LegendLuhar/flight-controller/README.md

# Flight Controller PCB

Custom STM32G474-based flight controller PCB and firmware project focused on embedded systems, hardware design, and real-time firmware development.
