LegendLuhar/flight-controller/flight-controller.kicad_pcb

## KiCad design flight-controller.kicad_pcb (2026-10-30)

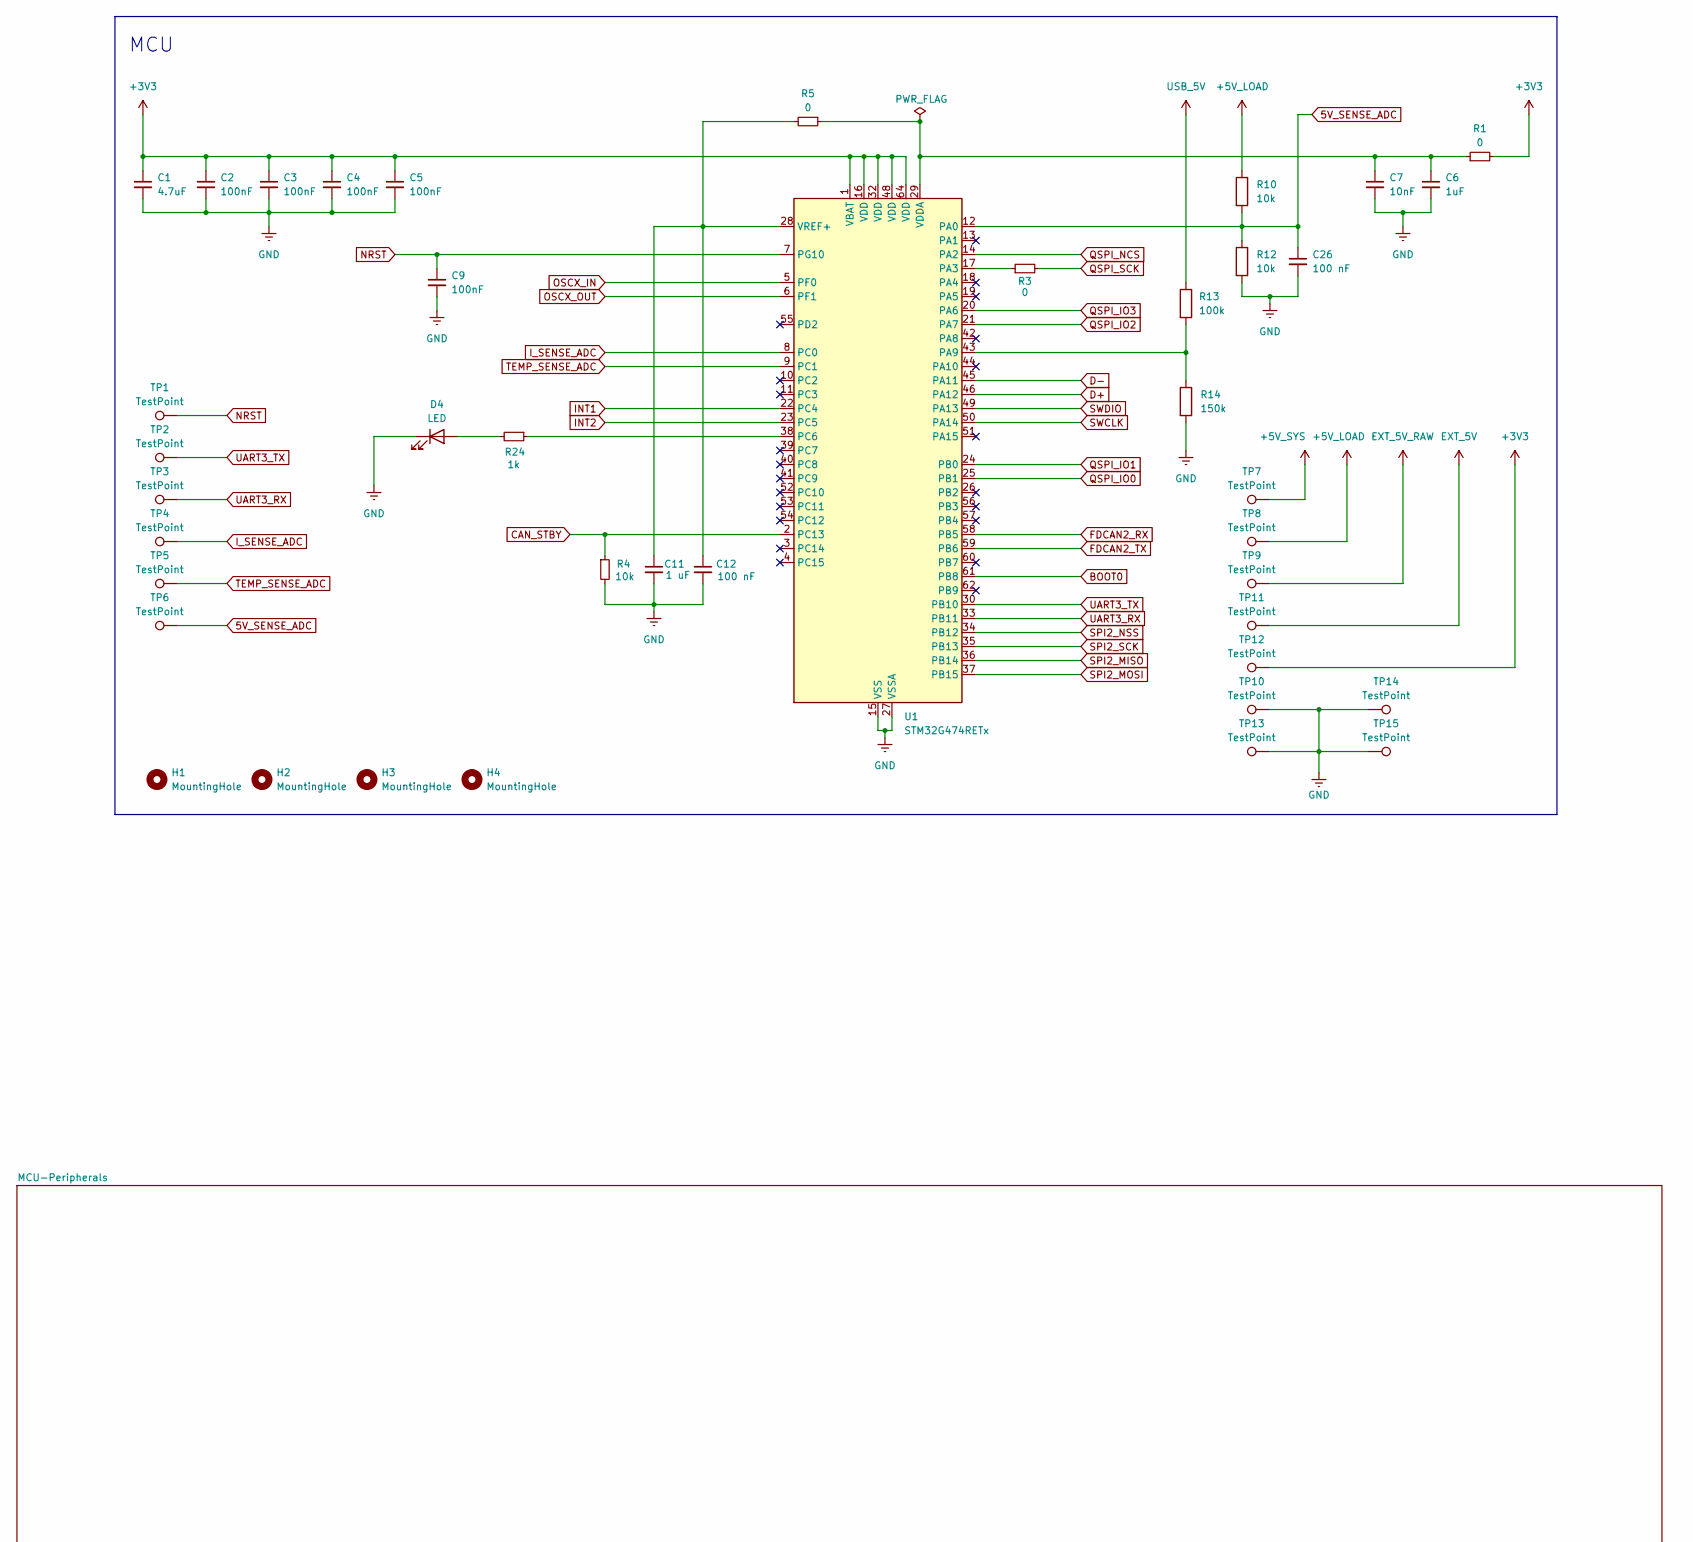
[picture p1: schematic flight-controller.kicad_sch, part in row 1, column 1]

Parts:
C1: 4.7uF; C_0805_2012Metric
C2, C3, C4, C5, C9: 100nF; C_0603_1608Metric
C6: 1uF; C_0603_1608Metric
C7: 10nF; C_0603_1608Metric
C11: 1 uF; C_0603_1608Metric
C12, C26: 100 nF; C_0603_1608Metric
D4: LED; LED_0603_1608Metric
H1, H2, H3, H4: MountingHole; MountingHole_3.2mm_M3_Pad_Via
R1, R3, R5: 0; R_0603_1608Metric
R4, R10, R12: 10k; R_0603_1608Metric
R13: 100k; R_0603_1608Metric
R14: 150k; R_0603_1608Metric
R24: 1k; R_0603_1608Metric
TP1, TP2, TP3, TP4, TP5, TP6, TP7, TP8, TP9, TP10, TP11, TP12, TP13, TP14, TP15: TestPoint; TestPoint_Pad_D1.0mm
U1: STM32G474RETx; LQFP-64_10x10mm_P0.5mm

Connections:
5V_SENSE_ADC: C26.1, R10.2, R12.1, TP6.1 (1_1), U1.12 (PA0)
+3V3: C1.1, C2.1, C3.1, C4.1, C5.1, R1.2, TP12.1 (1_1), U1.1 (VBAT), U1.16 (VDD), U1.32 (VDD), U1.48 (VDD), U1.64 (VDD); also elsewhere on the board
+5V_LOAD: R10.1, TP8.1 (1_1); also elsewhere on the board
+5V_SYS: TP7.1 (1_1); also elsewhere on the board
BOOT0: U1.61 (PB8); also elsewhere on the board
CAN_STBY: R4.1, U1.2 (PC13); also elsewhere on the board
D+: U1.46 (PA12); also elsewhere on the board
D-: U1.45 (PA11); also elsewhere on the board
EXT_5V: TP11.1 (1_1); also elsewhere on the board
EXT_5V_RAW: TP9.1 (1_1); also elsewhere on the board
FDCAN2_RX: U1.58 (PB5); also elsewhere on the board
FDCAN2_TX: U1.59 (PB6); also elsewhere on the board
GND: C1.2, C2.2, C3.2, C4.2, C5.2, C6.2, C7.2, C9.2, C11.2, C12.2, C26.2, D4.1 (K), R4.2, R12.2, R14.2, TP10.1 (1_1), TP13.1 (1_1), TP14.1 (1_1), TP15.1 (1_1), U1.15 (VSS), U1.27 (VSSA), U1.31 (VSS), U1.47 (VSS), U1.63 (VSS); also elsewhere on the board
INT1: U1.22 (PC4); also elsewhere on the board
INT2: U1.23 (PC5); also elsewhere on the board
I_SENSE_ADC: TP4.1 (1_1), U1.8 (PC0); also elsewhere on the board
NRST: C9.1, TP1.1 (1_1), U1.7 (PG10); also elsewhere on the board
unnamed: D4.2 (A), R24.2
unnamed: R3.1, U1.17 (PA3)
unnamed: R13.2, R14.1, U1.43 (PA9)
unnamed: R24.1, U1.38 (PC6)
unnamed: C6.1, C7.1, R1.1, R5.1, U1.29 (VDDA)
unnamed: C11.1, C12.1, R5.2, U1.28 (VREF+)
OSCX_IN: U1.5 (PF0); also elsewhere on the board
OSCX_OUT: U1.6 (PF1); also elsewhere on the board
QSPI_IO0: U1.25 (PB1); also elsewhere on the board
QSPI_IO1: U1.24 (PB0); also elsewhere on the board
QSPI_IO2: U1.21 (PA7); also elsewhere on the board
QSPI_IO3: U1.20 (PA6); also elsewhere on the board
QSPI_NCS: U1.14 (PA2); also elsewhere on the board
QSPI_SCK: R3.2; also elsewhere on the board
SPI2_MISO: U1.36 (PB14); also elsewhere on the board
SPI2_MOSI: U1.37 (PB15); also elsewhere on the board
SPI2_NSS: U1.34 (PB12); also elsewhere on the board
SPI2_SCK: U1.35 (PB13); also elsewhere on the board
SWCLK: U1.50 (PA14); also elsewhere on the board
SWDIO: U1.49 (PA13); also elsewhere on the board
TEMP_SENSE_ADC: TP5.1 (1_1), U1.9 (PC1); also elsewhere on the board
UART3_RX: TP3.1 (1_1), U1.33 (PB11); also elsewhere on the board
UART3_TX: TP2.1 (1_1), U1.30 (PB10); also elsewhere on the board
USB_5V: R13.1; also elsewhere on the board

Notes on the sheet:
MCU

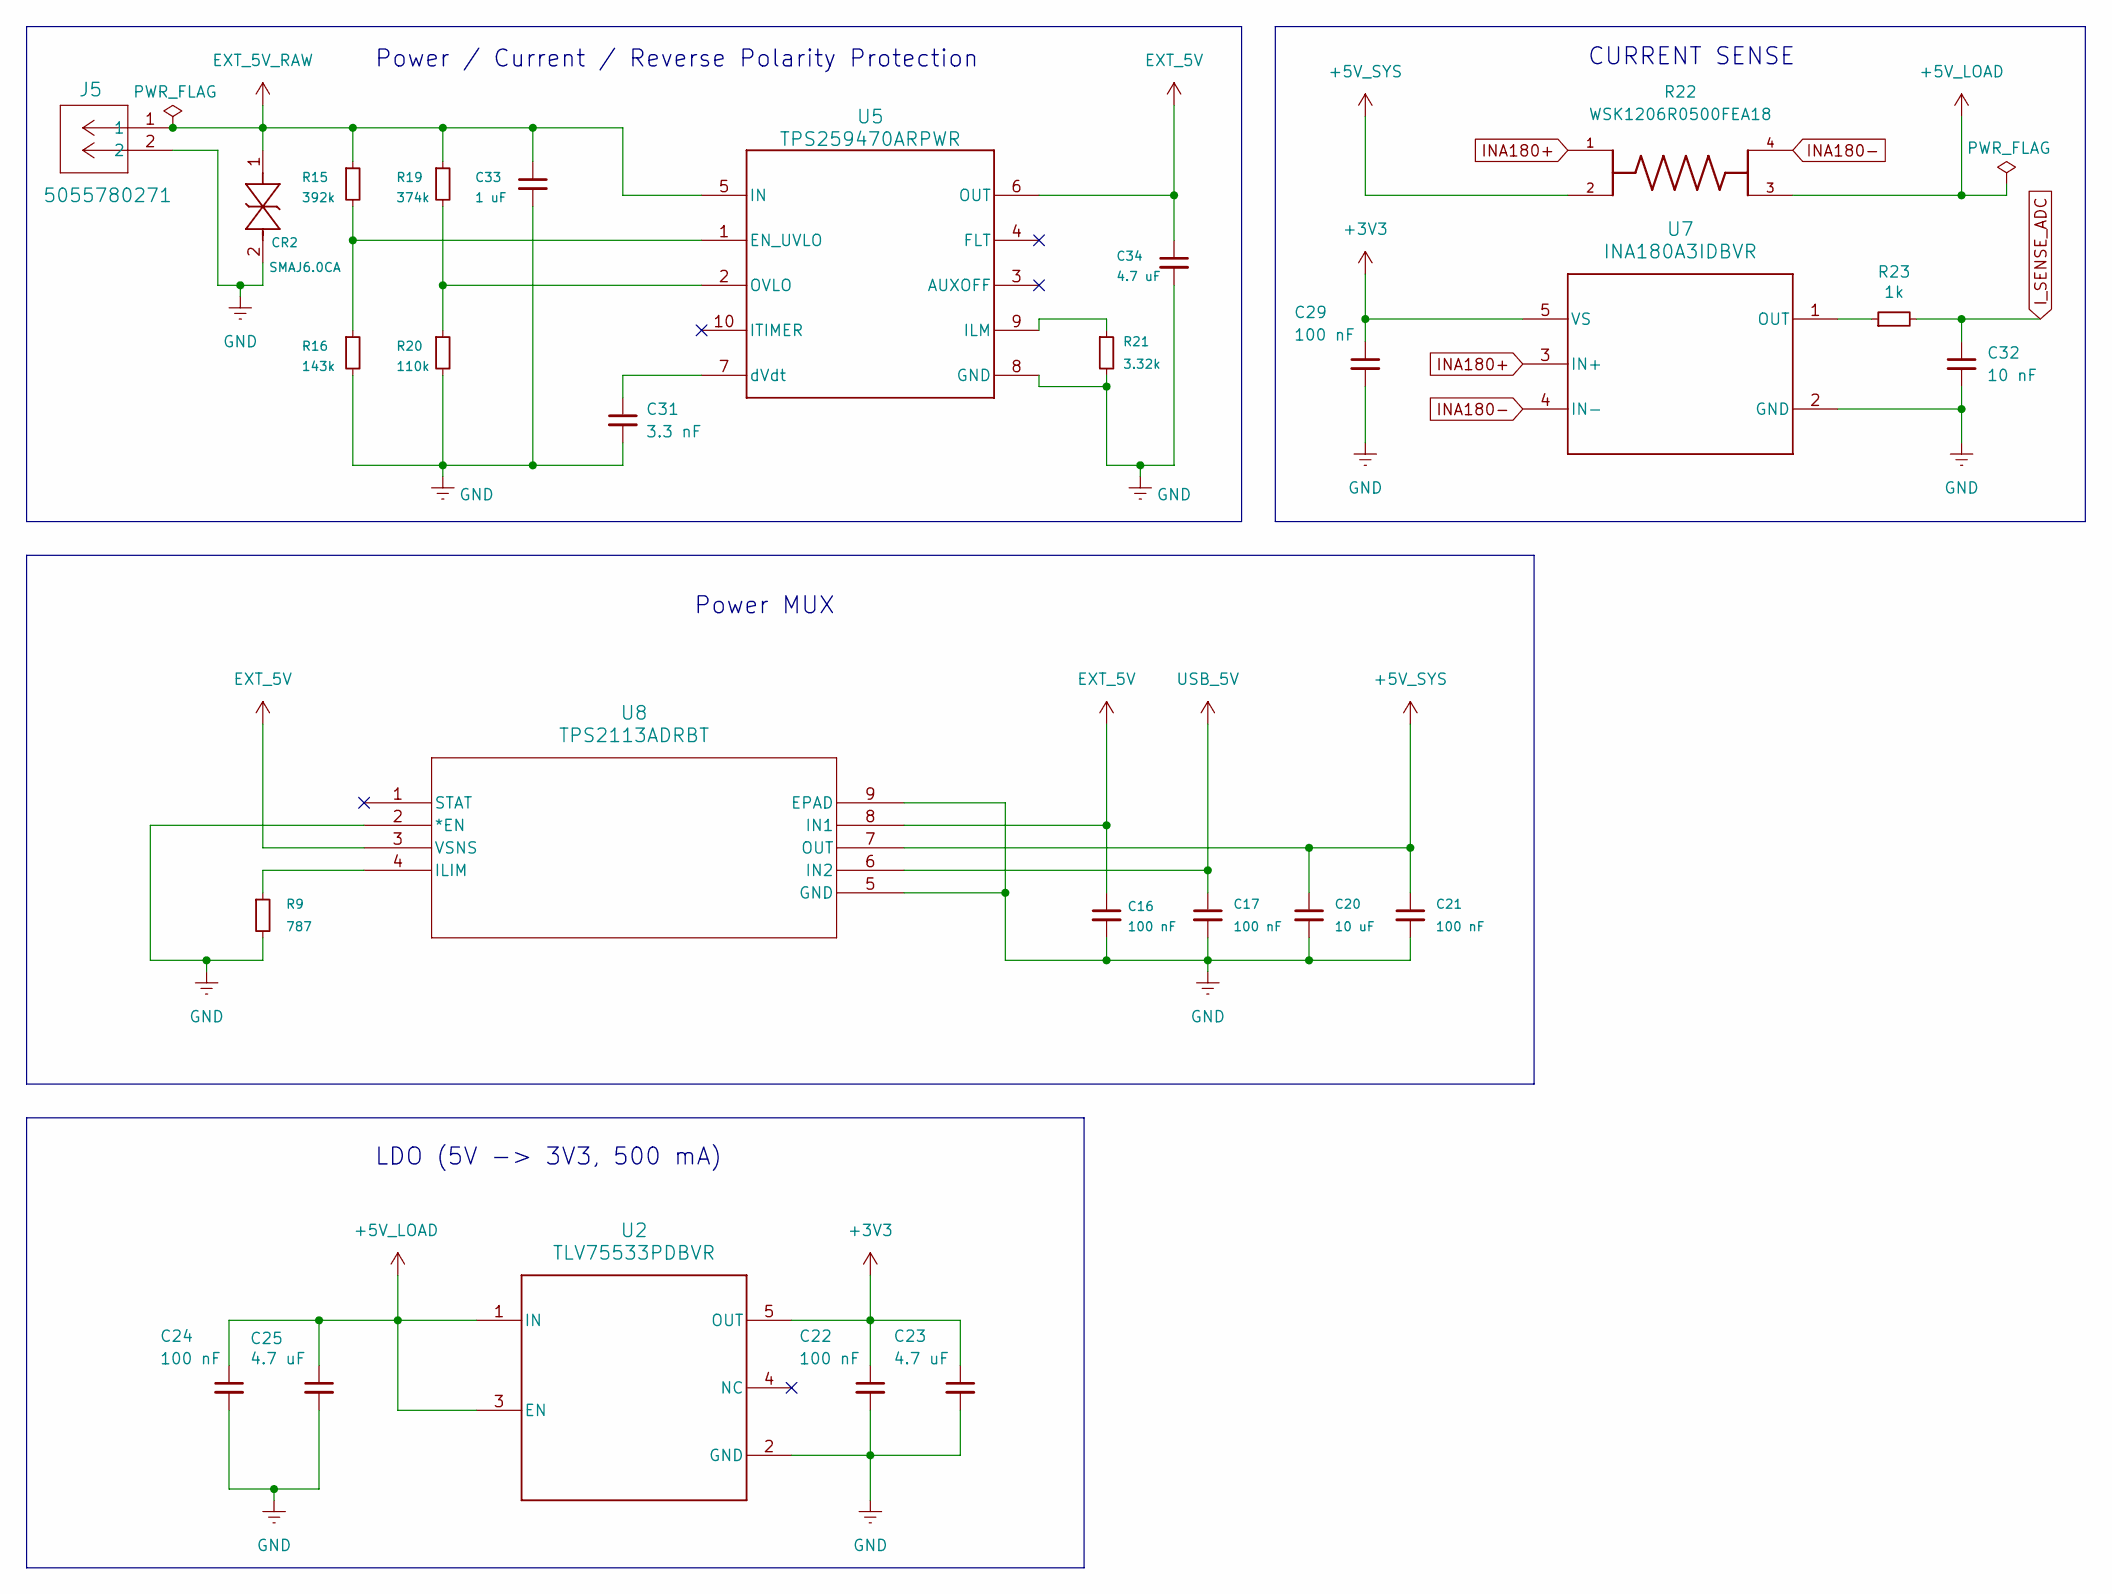
[picture p2: schematic power-architecture.kicad_sch]

Parts:
C16, C17, C21, C22, C24, C29: 100 nF; C_0603_1608Metric
C20: 10 uF; C_0603_1608Metric
C23, C25, C34: 4.7 uF; C_0805_2012Metric
C31: 3.3 nF; C_0603_1608Metric
C32: 10 nF; C_0603_1608Metric
C33: 1 uF; C_0603_1608Metric
CR2: SMAJ6.0CA; SMASeries_LTF
J5: 5055780271; CONN_505578_02_MOL
R9: 787; R_0603_1608Metric
R15: 392k; R_0603_1608Metric
R16: 143k; R_0603_1608Metric
R19: 374k; R_0603_1608Metric
R20: 110k; R_0603_1608Metric
R21: 3.32k; R_0603_1608Metric
R22: WSK1206R0500FEA18; RES_WSK1206R0500FEA18; PARTREV 26-Jul-2023
R23: 1k; R_0603_1608Metric
U2: TLV75533PDBVR; DBV0005A_L
U5: TPS259470ARPWR; RPW0010A-MFG
U7: INA180A3IDBVR; DBV0005A_L
U8: TPS2113ADRBT; DRB8_2P4X1P65

Connections:
+3V3: C22.1, C23.1, C29.1, U2.5 (OUT), U7.5 (VS); also elsewhere on the board
+5V_LOAD: C24.1, C25.1, R22.3, U2.1 (IN), U2.3 (EN); also elsewhere on the board
+5V_SYS: C20.1, C21.1, R22.2, U8.7 (OUT); also elsewhere on the board
EXT_5V: C16.1, C34.1, U5.6 (OUT), U8.3 (VSNS), U8.8 (IN1); also elsewhere on the board
EXT_5V_RAW: C33.1, CR2.1, J5.1, R15.1, R19.1, U5.5 (IN); also elsewhere on the board
GND: C16.2, C17.2, C20.2, C21.2, C22.2, C23.2, C24.2, C25.2, C29.2, C31.2, C32.2, C33.2, C34.2, CR2.2, J5.2, R9.2, R16.2, R20.2, R21.2, U2.2 (GND), U5.8 (GND), U7.2 (GND), U8.2 (*EN), U8.5 (GND), U8.9 (EPAD); also elsewhere on the board
INA180+: R22.1, U7.3 (IN+)
INA180-: R22.4, U7.4 (IN-)
I_SENSE_ADC: C32.1, R23.2; also elsewhere on the board
unnamed: R15.2, R16.1, U5.1 (EN_UVLO)
unnamed: R21.1, U5.9 (ILM)
unnamed: R19.2, R20.1, U5.2 (OVLO)
unnamed: C31.1, U5.7 (dVdt)
unnamed: R23.1, U7.1 (OUT)
unnamed: R9.1, U8.4 (ILIM)
USB_5V: C17.1, U8.6 (IN2); also elsewhere on the board

Notes on the sheet:
LDO (5V -> 3V3, 500 mA)
Power MUX
CURRENT SENSE
Power / Current / Reverse Polarity Protection

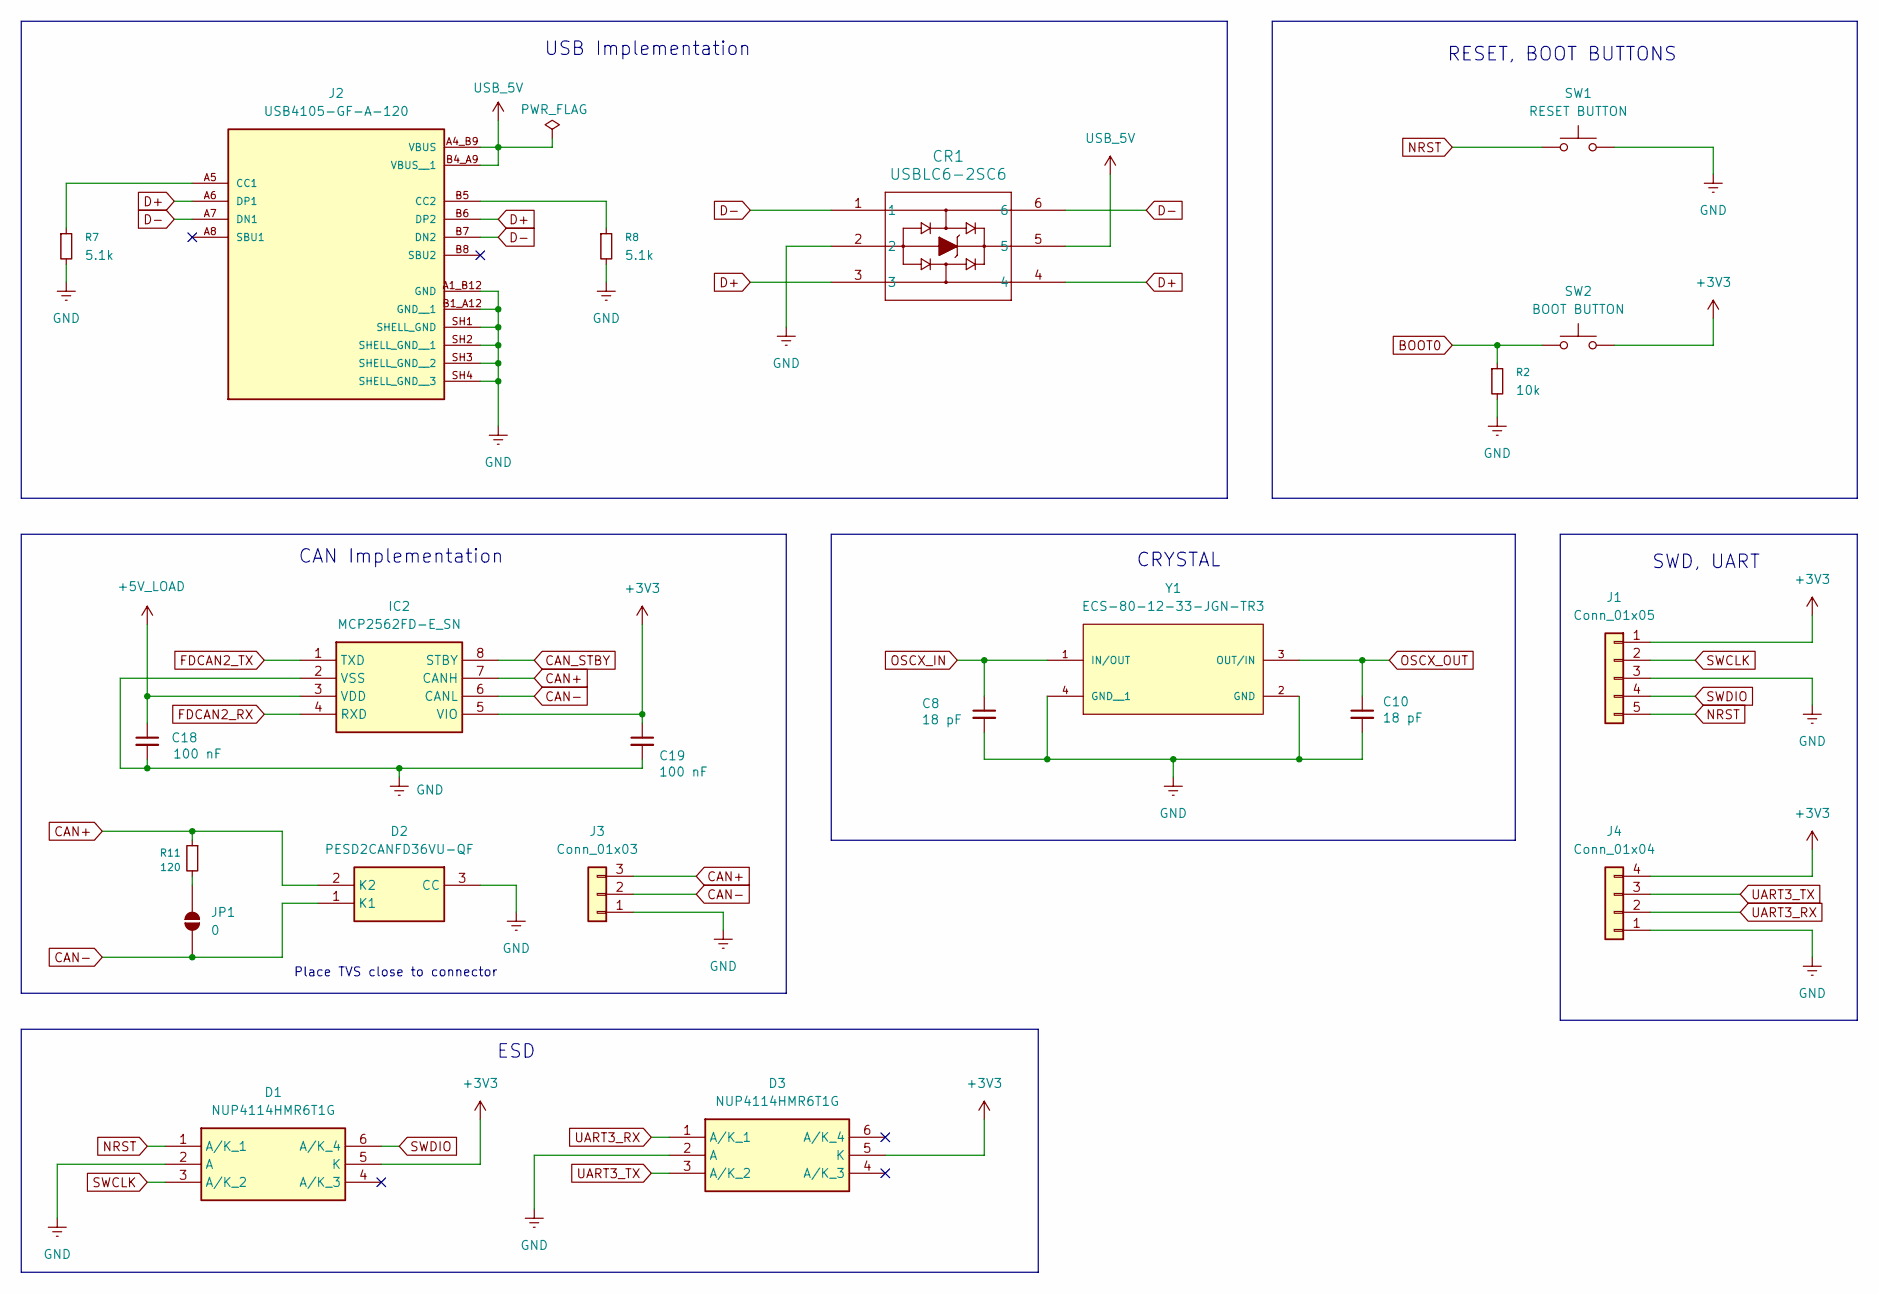
[picture p3: schematic MCU-Peripherals.kicad_sch]

Parts:
C8, C10: 18 pF; C_0603_1608Metric
C18, C19: 100 nF; C_0603_1608Metric
CR1: USBLC6-2SC6; SOT23-6L_STM
D1, D3: NUP4114HMR6T1G; SOT95P275X110-6N; Mouser Part Number 863-NUP4114HMR6T1G
D2: PESD2CANFD36VU-QF; PESD2CANFD36VUQF; Mouser Part Number 771-PESD2CANFD36VUQF
IC2: MCP2562FD-E_SN; SOIC127P600X175-8N; Mouser Part Number 579-MCP2562FD-E/SN
J1: Conn_01x05; JST_GH_SM05B-GHS-TB_1x05-1MP_P1.25mm_Horizontal
J2: USB4105-GF-A-120; GCT_USB4105-GF-A-120; PARTREV B3
J3: Conn_01x03; JST_GH_SM03B-GHS-TB_1x03-1MP_P1.25mm_Horizontal
J4: Conn_01x04; JST_GH_SM04B-GHS-TB_1x04-1MP_P1.25mm_Horizontal
JP1: 0; R_0603_1608Metric
R2: 10k; R_0603_1608Metric
R7, R8: 5.1k; R_0603_1608Metric
R11: 120; R_0603_1608Metric
SW1: RESET BUTTON; SW_SPST_SKQG_WithStem
SW2: BOOT BUTTON; SW_SPST_SKQG_WithStem
Y1: ECS-80-12-33-JGN-TR3; XTAL_ECS-240-8-33-AGN-TR

Connections:
+3V3: C19.1, D1.5 (K), D3.5 (K), IC2.5 (VIO), J1.1, J4.4, SW2.2; also elsewhere on the board
+5V_LOAD: C18.1, IC2.3 (VDD); also elsewhere on the board
BOOT0: R2.1, SW2.1; also elsewhere on the board
CAN+: D2.2 (K2), IC2.7 (CANH), J3.3, R11.1
CAN-: D2.1 (K1), IC2.6 (CANL), J3.2, JP1.1 (A)
CAN_STBY: IC2.8 (STBY); also elsewhere on the board
D+: CR1.3, CR1.4, J2.A6 (DP1), J2.B6 (DP2); also elsewhere on the board
D-: CR1.1, CR1.6, J2.A7 (DN1), J2.B7 (DN2); also elsewhere on the board
FDCAN2_RX: IC2.4 (RXD); also elsewhere on the board
FDCAN2_TX: IC2.1 (TXD); also elsewhere on the board
GND: C8.2, C10.2, C18.2, C19.2, CR1.2, D1.2 (A), D2.3 (CC), D3.2 (A), IC2.2 (VSS), J1.3, J2.A1_B12 (GND), J2.B1_A12 (GND__1), J2.SH1 (SHELL_GND), J2.SH2 (SHELL_GND__1), J2.SH3 (SHELL_GND__2), J2.SH4 (SHELL_GND__3), J3.1, J4.1, R2.2, R7.2, R8.2, SW1.2, Y1.2 (GND), Y1.4 (GND__1); also elsewhere on the board
NRST: D1.1 (A/K_1), J1.5, SW1.1; also elsewhere on the board
unnamed: J2.A5 (CC1), R7.1
unnamed: J2.B5 (CC2), R8.1
unnamed: JP1.2 (B), R11.2
OSCX_IN: C8.1, Y1.1 (IN/OUT); also elsewhere on the board
OSCX_OUT: C10.1, Y1.3 (OUT/IN); also elsewhere on the board
SWCLK: D1.3 (A/K_2), J1.2; also elsewhere on the board
SWDIO: D1.6 (A/K_4), J1.4; also elsewhere on the board
UART3_RX: D3.1 (A/K_1), J4.2; also elsewhere on the board
UART3_TX: D3.3 (A/K_2), J4.3; also elsewhere on the board
USB_5V: CR1.5, J2.A4_B9 (VBUS), J2.B4_A9 (VBUS__1); also elsewhere on the board

Notes on the sheet:
ESD
RESET, BOOT BUTTONS
CAN Implementation
SWD, UART
USB Implementation
CRYSTAL
Place TVS close to connector

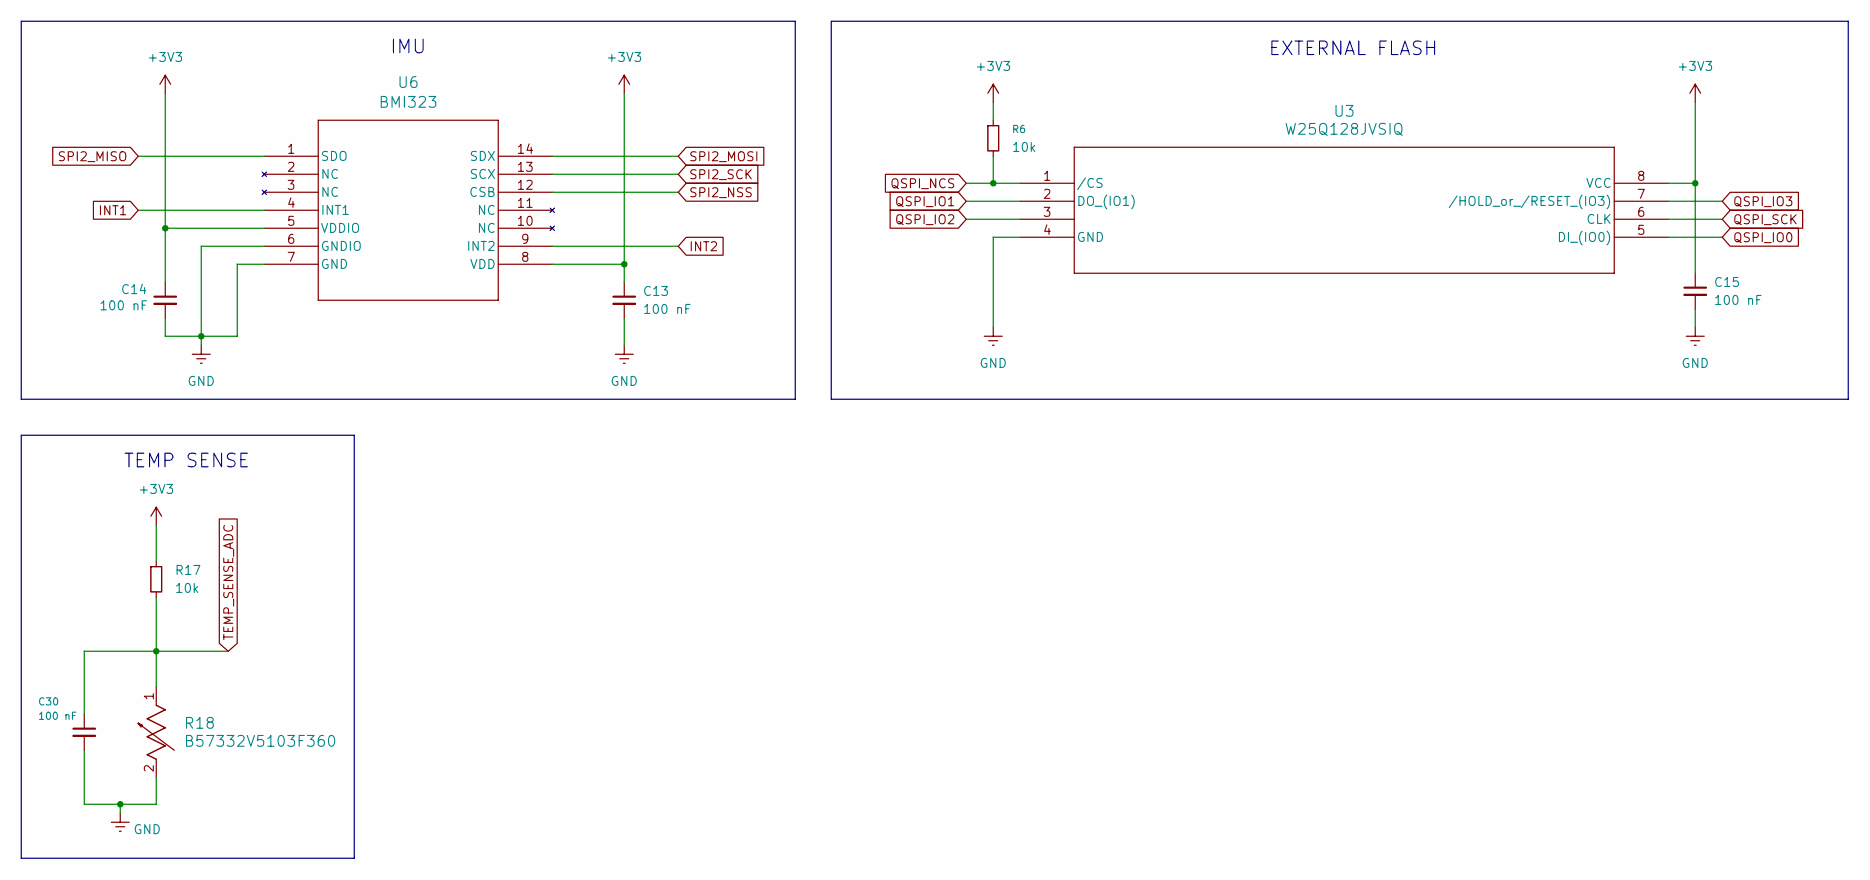
[picture p4: schematic IMU.kicad_sch]

Parts:
C13, C14, C15, C30: 100 nF; C_0603_1608Metric
R6, R17: 10k; R_0603_1608Metric
R18: B57332V5103F360; TRES_B57332V5103F360
U3: W25Q128JVSIQ; SOIC_128JVSIQ_WIN
U6: BMI323; BMI323_BOS

Connections:
+3V3: C13.1, C14.1, C15.1, R6.1, R17.1, U3.8 (VCC), U6.5 (VDDIO), U6.8 (VDD); also elsewhere on the board
GND: C13.2, C14.2, C15.2, C30.2, R18.2, U3.4 (GND), U6.6 (GNDIO), U6.7 (GND); also elsewhere on the board
INT1: U6.4 (INT1); also elsewhere on the board
INT2: U6.9 (INT2); also elsewhere on the board
QSPI_IO0: U3.5 (DI_(IO0)); also elsewhere on the board
QSPI_IO1: U3.2 (DO_(IO1)); also elsewhere on the board
QSPI_IO2: U3.3; also elsewhere on the board
QSPI_IO3: U3.7 (/HOLD_or_/RESET_(IO3)); also elsewhere on the board
QSPI_NCS: R6.2, U3.1 (/CS); also elsewhere on the board
QSPI_SCK: U3.6 (CLK); also elsewhere on the board
SPI2_MISO: U6.1 (SDO); also elsewhere on the board
SPI2_MOSI: U6.14 (SDX); also elsewhere on the board
SPI2_NSS: U6.12 (CSB); also elsewhere on the board
SPI2_SCK: U6.13 (SCX); also elsewhere on the board
TEMP_SENSE_ADC: C30.1, R17.2, R18.1; also elsewhere on the board

Notes on the sheet:
TEMP SENSE
IMU
EXTERNAL FLASH

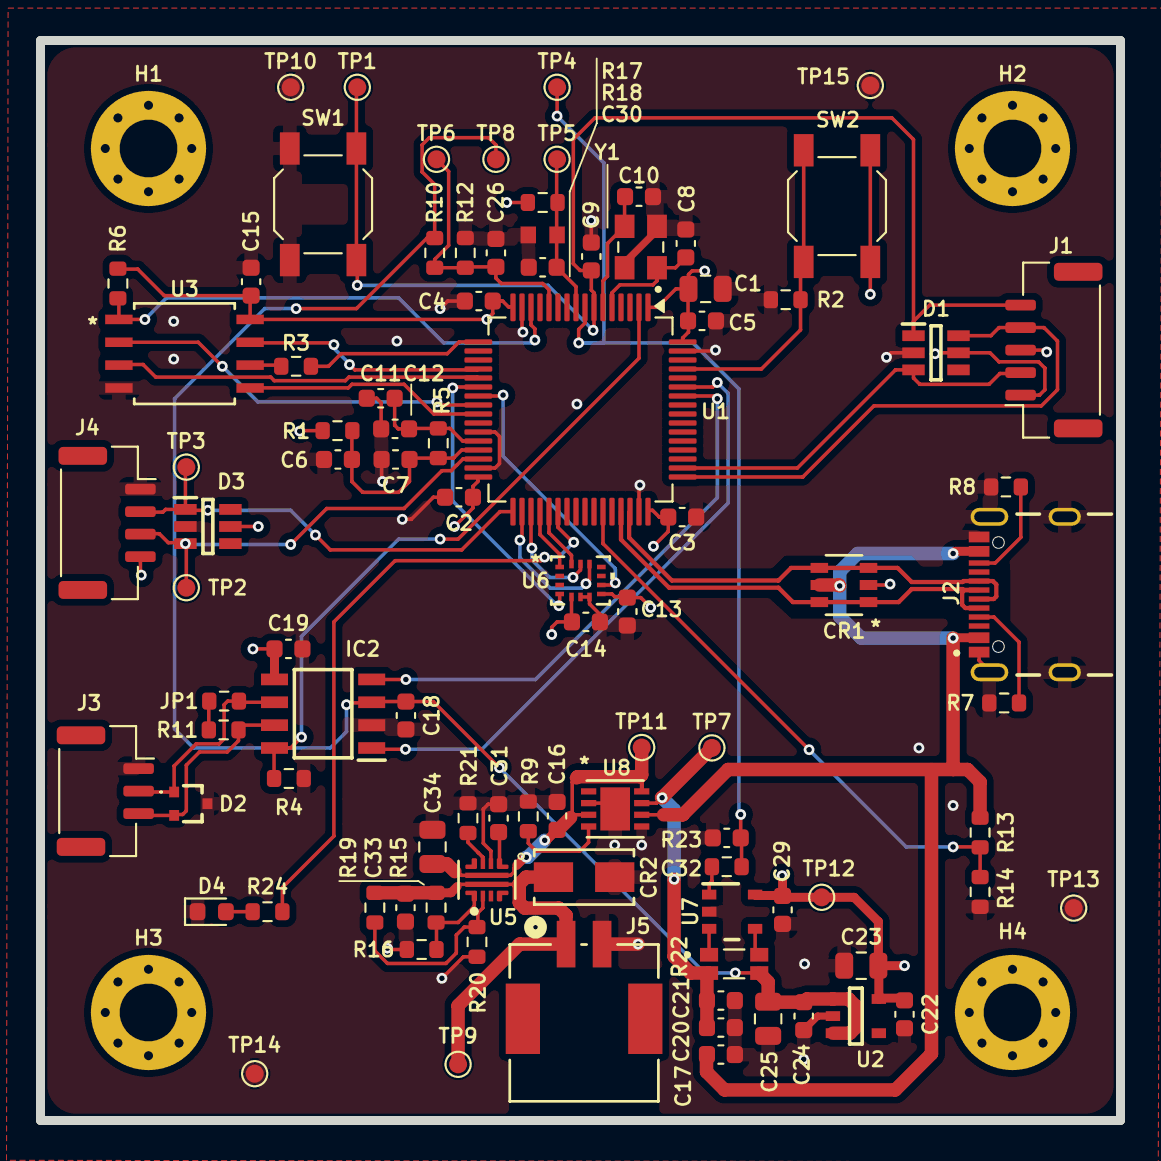
[picture p5: board flight-controller.kicad_pcb from above]

Board: 4 copper layers, 60.0 x 60.0 mm, 98 parts (0 on the bottom side), 54 nets.
