LegendLuhar/flight-controller/(commit log)

2026-08-12 Initialize KiCad flight controller project
    [flight-controller.kicad_pcb, flight-controller.kicad_sch]
2026-08-13 Add STM32G474 to schematic
    [flight-controller.kicad_sch]
2026-08-21 Some schematic progress
    [MCU-Peripherals.kicad_sch, flight-controller.kicad_sch]
2026-09-18 Decent progress, started USB
    [MCU-Peripherals.kicad_sch, flight-controller.kicad_sch]
2026-09-25 Further schematic progress
    [IMU.kicad_sch, MCU-Peripherals.kicad_sch, Sensors.kicad_sch, flight-controller.kicad_sch]
2026-10-21 Completed Schematic
2026-10-28 PCB Layout Component placement progress
2026-10-28 Finished PCB Component Placement
2026-10-30 COMPLETED THE PCB WOOOO
